The-Real-Frigobox-Organisation/1920PROSmartFrigobox/Schemas/IMG_20200521_195326.jpg

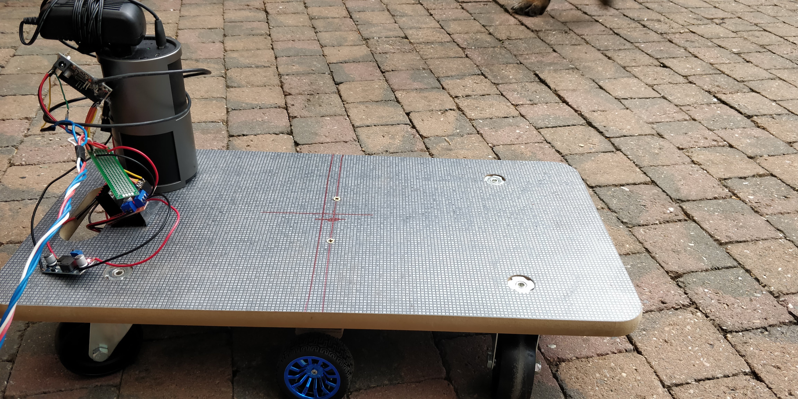
Schemas/IMG_20200521_195326.jpg
