The-Real-Frigobox-Organisation/1920PROSmartFrigobox/Schemas/Top down view.pdf

225 mm

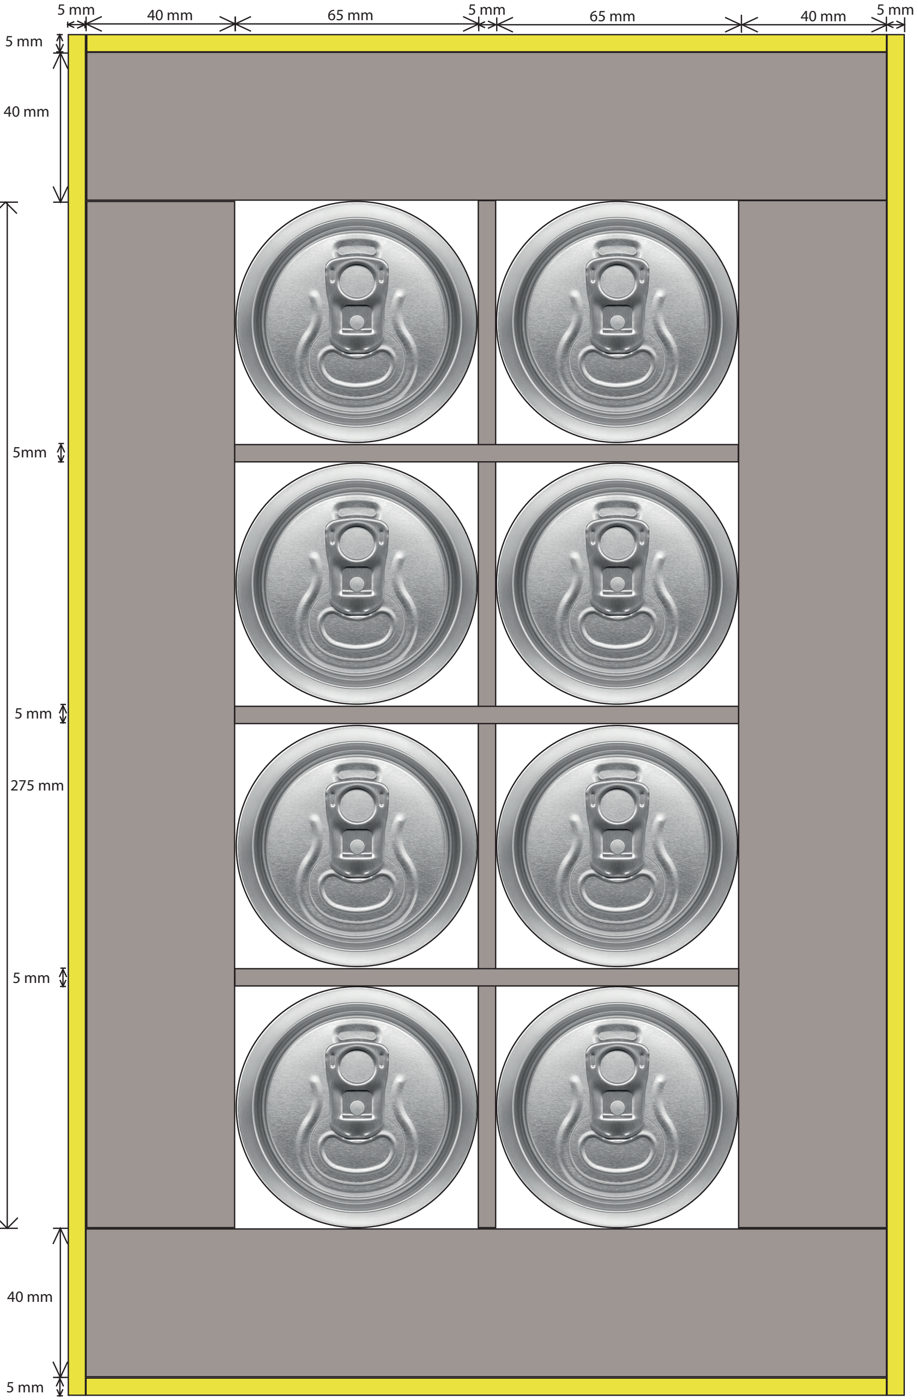
[picture p22: figure]

360 mm

ISOLATIE

MDF OF ANDER STEVIG MATERIAAL

### Top down view Project smart frigobox Odisee 2ELOICT
