The-Real-Frigobox-Organisation/1920PROSmartFrigobox/Documentatie/poster.jpg

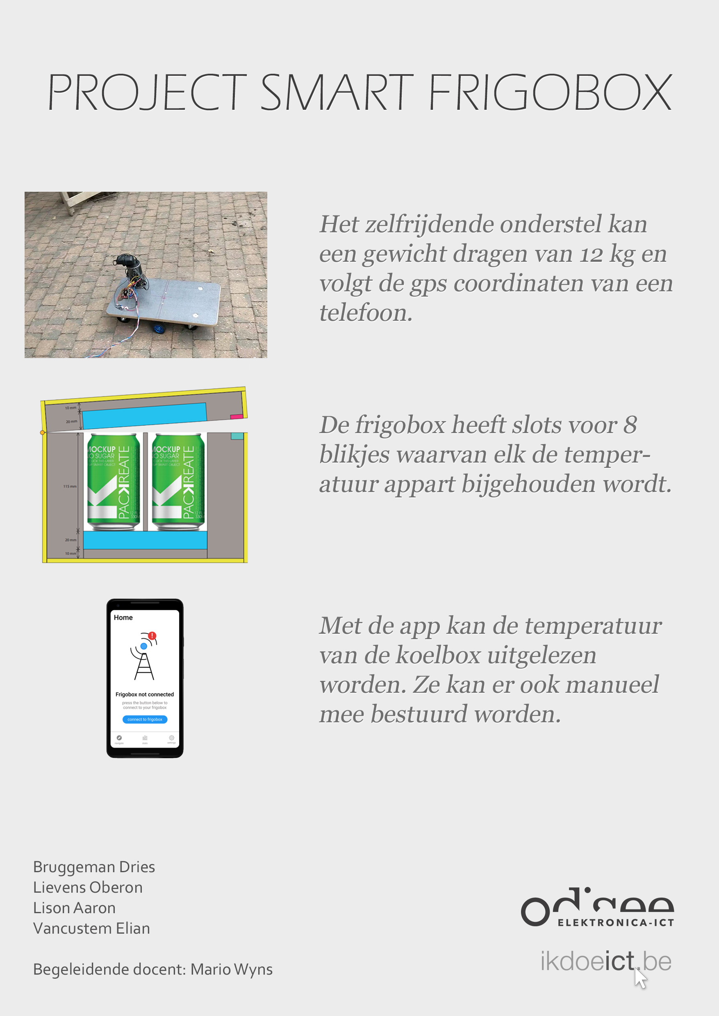
Documentatie/poster.jpg
