The-Real-Frigobox-Organisation/1920PROSmartFrigobox/Schemas/330ml-Beer-Can-Size.jpg

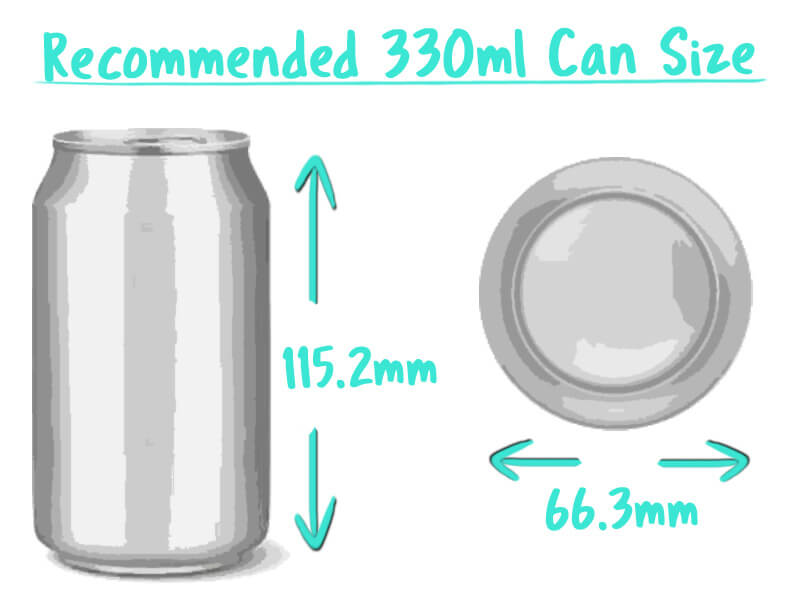
Schemas/330ml-Beer-Can-Size.jpg
