The-Real-Frigobox-Organisation/1920PROSmartFrigobox/Schemas/tekening.jpg

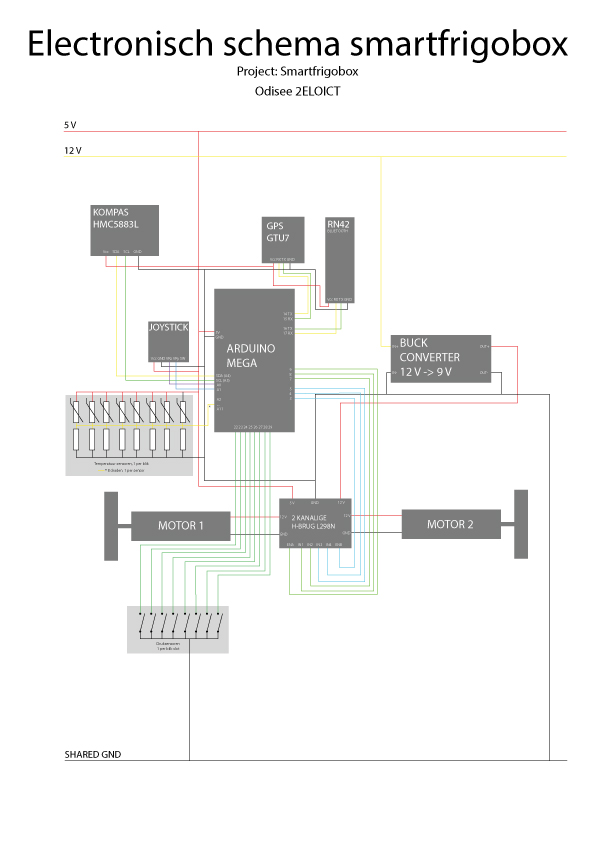
Schemas/tekening.jpg
