The-Real-Frigobox-Organisation/1920PROSmartFrigobox/Schemas/Electrisch schema project.pdf

5 V

12 V

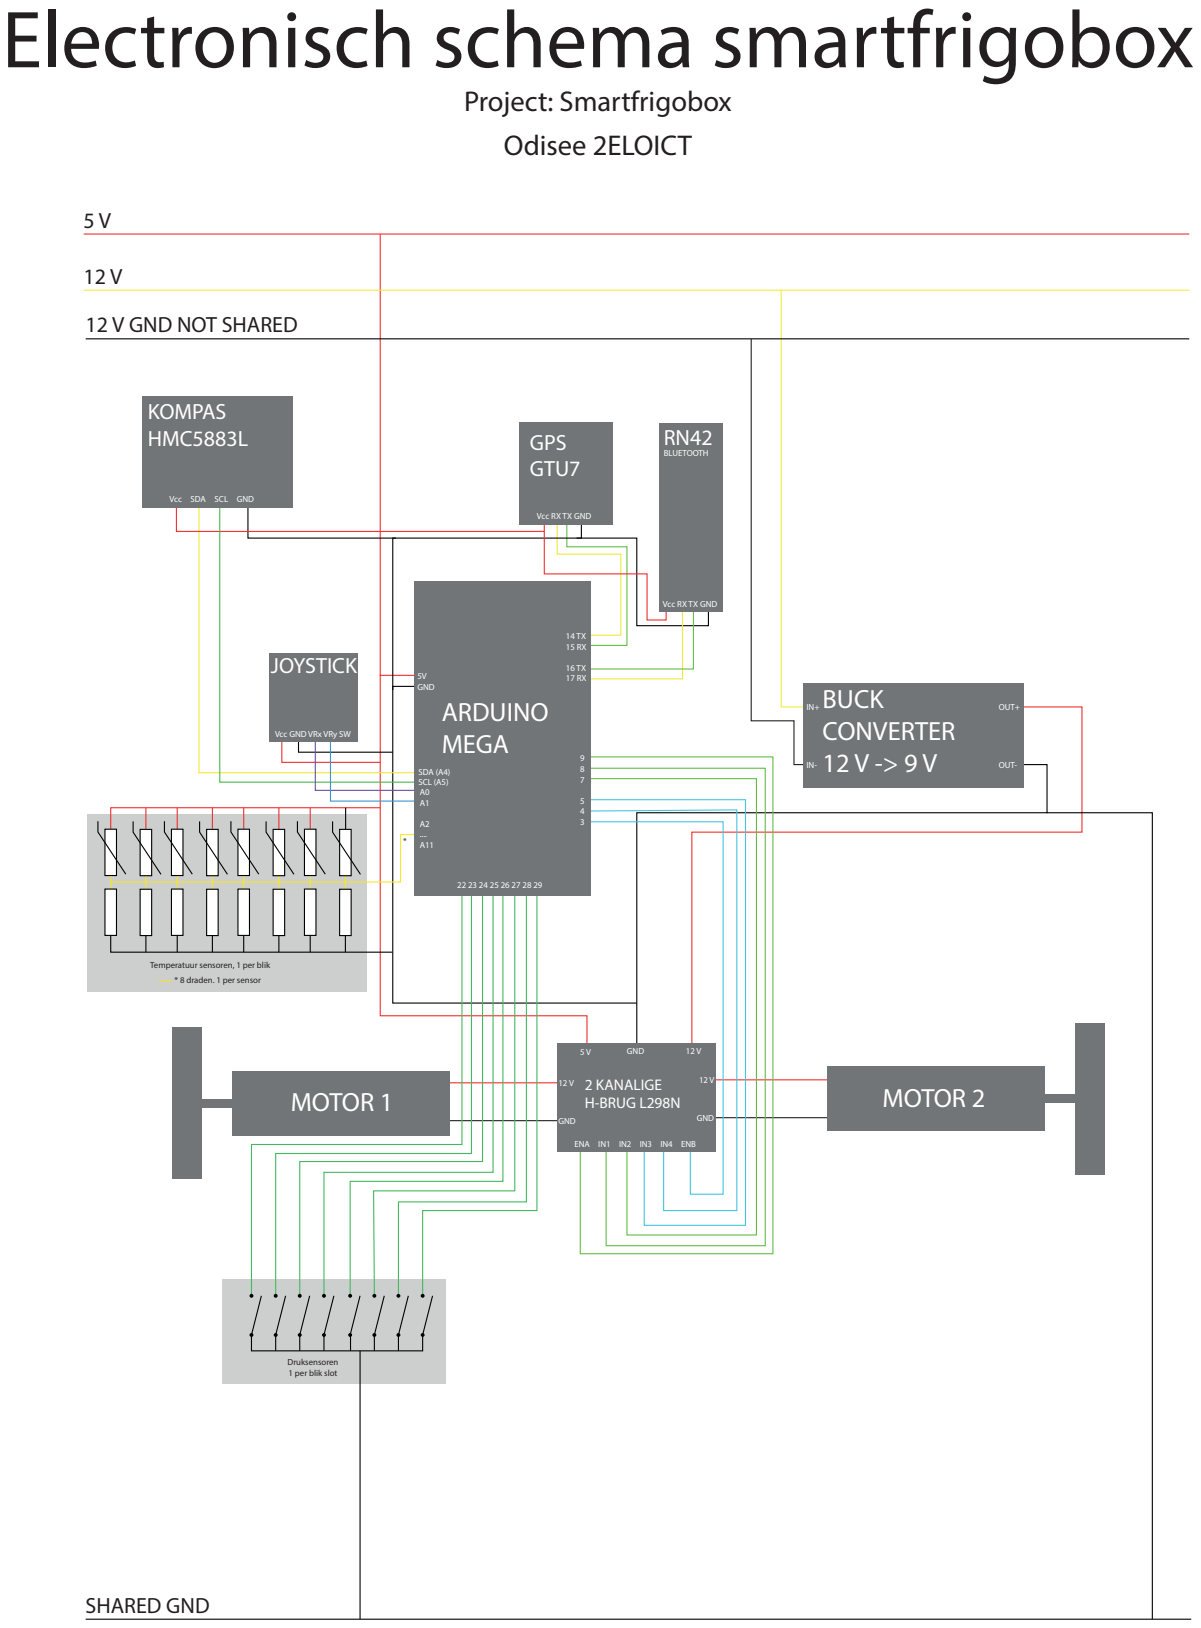
[picture p26: page 1]
BUCK CONVERTER 12 V -> 9 V; OUT+; OUT-; MOTOR 1; MOTOR 2; ARDUINO MEGA; 5V GND; SDA (A4) SCL (A5) A0 A1; 2 KANALIGE H-BRUG L298N; GND; ENA IN1 IN2 IN3 IN4 ENB; SHARED GND; GPS GTU7; KOMPAS HMC5883L; BLUETOOTH; Project: Smartfrigobox Odisee 2ELOICT; JOYSTICK

Electronisch schema smartfrigobox

12 V GND NOT SHARED

Vcc SDA SCL GND

Vcc RX TX GND

Vcc GND VRx VRy SW

Temperatuur sensoren, 1 per blik
* 8 draden. 1 per sensor

Druksensoren
1 per blik slot
