The-Real-Frigobox-Organisation/1920PROSmartFrigobox/Schemas/side view frigobox.pdf

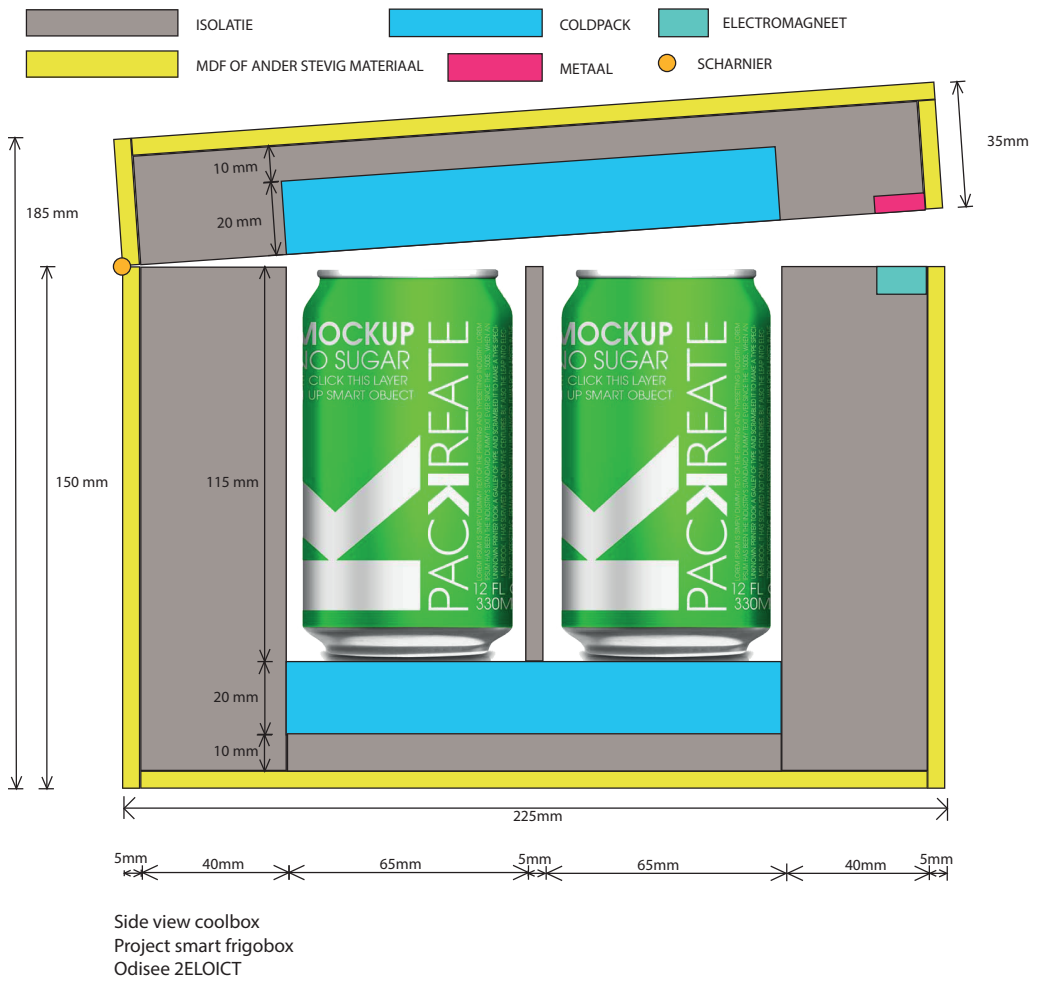
[picture p27: page 1]
ISOLATIE; COLDPACK; METAAL; ELECTROMAGNEET; SCHARNIER

MDF OF ANDER STEVIG MATERIAAL

Side view coolbox
Project smart frigobox
Odisee 2ELOICT
